zone883/stc89c52-charge-protector/I2C.h

#ifndef __I2C_H__
#define __I2C_H__

void I2C_Start(void);
void I2C_Stop(void);
bit I2C_SendByte(unsigned char Byte);
unsigned char I2C_ReceiveByte(void);
void I2C_SendAck(bit AckBit);
bit I2C_ReceiveAck(void);

#endif
