zone883/stc89c52-charge-protector/(commit log)

2026-10-11 feat: STC89C52 lithium-battery charging protector
    - INA219-based over-current / full-charge detection with relay cutoff
    - Adjustable thresholds via on-board keys; charging-time counter
    - LCD1602 + on-board LED bar status display
    - DS18B20 thermal protection retained in code (disabled: sensor pin loose)
    - Keil C51 project; prebuilt hex in Objects/
    [I2C.c, I2C.h, INA219.c]
2026-10-11 refactor: revert to the author's original implementation
    - Restore original main.c and all modules exactly as the author wrote them
    - Only fix: add I2C_ReceiveByte() / I2C_SendAck() to I2C.c (declared in
    I2C.h but never implemented, which caused UNRESOLVED EXTERNAL SYMBOL
    warnings and a broken link output)
    - Rebuild hex: 0 Error / 4 L16 warnings, code=1583
    - README rewritten around the real implementation and the three hardware
    issues (loose DS18B20 pin, cold-soldered INA219 terminal, LCD1602
    contact problems - LCD reused as the load, backlight works)
    - Remove demo PPT from the repository
    [I2C.c, I2C.h, INA219.c, Key.c]
